TheOneTheProdigy/OMRA-LocoNet-DCC-Booster/PCB/Board Manufacturing Files/BOM_LN-DCC-Booster_V1_3.csv

ID | Name | Designator | Footprint | Quantity | Manufacturer Part | Manufacturer | Supplier | Supplier Part | Price | Pins
1 | XY2500R-C-5.08-3P | CN4,CN3,CN5 | CONN-TH_XY2500R-C-5.08-3P | 3 | XY2500R-C-5.08-3P | XINLAIYA(新莱亚) | LCSC | C505807 | 0.088 | 3
2 | 220Ω | R4,R21 | RES-TH_BD2.3-L6.5-P10.50-D0.5 | 2 | RI40-1/4W-220Ω ±5% T | CCO(千志电子) | LCSC | C136549 | 0.074 | 2
3 | 22kΩ | R5,R20,R3 | RES-TH_BD2.3-L6.5-P10.50-D0.5 | 3 | RI40-1/4W-22KΩ ±5% T | CCO(千志电子) | LCSC | C136549 | 0.074 | 2
4 | 680Ω | R6 | RES-TH_BD2.3-L6.5-P10.50-D0.5 | 1 | RI40-1/4W-680Ω ±5% T | CCO(千志电子) | LCSC | C136549 | 0.074 | 2
5 | MST 2A 250V | F1 | FUSE-TH_L8.4-W4.3-P5.08-D1.0 | 1 | MST 2A 250V | CONQUER(功得) | LCSC | C388802 | 0.042 | 2
6 | 100nF (104) | C1,C2,C4,C7 | 100NF (104) 100V 5.08MM LAYOUT 1 | 4 |  |  |  |  |  | 2
7 | 10uF (106) | C3 | 100NF (104) 100V 5.08MM LAYOUT 1 | 1 |  |  |  |  |  | 2
8 | 10uF | C6 | 100NF (104) 100V 5.08MM LAYOUT 1 | 1 |  |  |  |  |  | 2
9 | 4.7uF | C8 | 100NF (104) 100V 5.08MM LAYOUT 1 | 1 |  |  |  |  |  | 2
10 | RJ12_95501-2661 | CN1,CN2 | RJ12-TH_95501-2661 | 2 | 95501-2661 | MOLEX | LCSC | C240856 | 0.582 | 6
11 | 1N4148 | D2 | DO-35_BD2.0-L4.2-P8.20-D0.5-RD | 1 | 1N4148 | LGE(鲁光) | LCSC | C402212 | 0.008 | 2
12 | 1N4733A-TAP | D6,D8 | DO-41_BD2.4-L4.7-P8.70-D0.9-RD | 2 | 1N4733A-TAP | VISHAY(威世) | LCSC | C241985 | 0.075 | 2
13 | SSD1306-128X64-I2C-0.96 | OLED | SSD1306-128X64-I2C | 1 |  |  |  |  |  | 4
14 | 2N3904 | Q2 | TO-92-3_L5.1-W4.1-P1.27-L | 1 | 2N3904 | ST(先科) | LCSC | C118538 | 0.016 | 3
15 | 2N7000-D75Z | Q3 | TO-92-3_L4.8-W3.7-P2.54-L | 1 | 2N7000-D75Z | onsemi(安森美) | LCSC | C900718 | 0.233 | 3
16 | 47kΩ | R1 | RES-TH_BD2.3-L6.5-P10.50-D0.5 | 1 | RI40-1/4W-47KΩ ±5% T | CCO(千志电子) | LCSC | C136549 | 0.074 | 2
17 | 150kΩ | R2 | RES-TH_BD2.3-L6.5-P10.50-D0.5 | 1 | RI40-1/4W-150KΩ ±5% T | CCO(千志电子) | LCSC | C136549 | 0.074 | 2
18 | 1kΩ | R7,R10,R15 | RES-TH_BD2.3-L6.5-P10.50-D0.5 | 3 | RI40-1/4W-1KΩ ±5% T | CCO(千志电子) | LCSC | C136549 | 0.074 | 2
19 | 4k7Ω | R8,R9,R18,R19 | RES-TH_BD2.3-L6.5-P10.50-D0.5 | 4 | RI40-1/4W-4K7Ω ±5% T | CCO(千志电子) | LCSC | C136549 | 0.074 | 2
20 | 2.2kΩ | R11 | RES-TH_BD2.3-L6.5-P10.50-D0.5 | 1 | RI40-1/4W-2K2Ω ±5% T | CCO(千志电子) | LCSC | C136549 | 0.074 | 2
21 | 620Ω | R12 | RES-TH_BD2.3-L6.5-P10.50-D0.5 | 1 | RI40-1/4W-620KΩ ±5% T | CCO(千志电子) | LCSC | C136549 | 0.074 | 2
22 | 300Ω | R13,R16 | RES-TH_BD2.3-L6.5-P10.50-D0.5 | 2 | RI40-1/4W-300Ω ±5% T | CCO(千志电子) | LCSC | C136549 | 0.074 | 2
23 | 10kΩ | R14 | RES-TH_BD2.3-L6.5-P10.50-D0.5 | 1 | RI40-1/4W-10KΩ ±5% T | CCO(千志电子) | LCSC | C136549 | 0.074 | 2
24 | Arduino Pro Micro | U1 | ARDUINOPROMICRO | 1 |  |  |  |  |  | 24
25 | 6N137M | U2 | DIP-8_L9.7-W6.6-LS7.62-P2.54-BL | 1 | 6N137M | onsemi(安森美) | LCSC | C5344 | 0.637 | 8
26 | 7805 | U3 | TO-220-3_L10.0-W4.5-P2.54-L | 1 | 7805 | PUOLOP(迪浦) | LCSC | C2843718 | 0.178 | 3
27 | LM2596 | U4 | LM2596 | 1 |  |  |  |  |  | 4
28 | LM311P | U5 | DIP-8_L10.0-W6.5-P2.54-LS7.6-BL-1 | 1 | LM311P | TI(德州仪器) | LCSC | C5219 | 0.3 | 8
29 | LTV-4N35 | U6,U9 | DIP-6_L7.3-W6.5-P2.54-LS7.6-BL | 2 | LTV-4N35 | LITEON(光宝) | LCSC | C343878 | 0.153 | 6
30 | BTS7960 / IBT-2 | U7,U8 | BTS7960 | 2 |  |  |  | undefined |  | 8
31 | IBT2 | U7-2,U8-2 | IBT2 | 2
32 | B0505S-1W | U10 | PWRM-TH_BXXXXS-1W | 1 | B0505S-1W | HENIPER(恒浦) | LCSC | C234073 |  | 4
