TheOneTheProdigy/OMRA-LocoNet-DCC-Booster/PCB/Board Manufacturing Files/PCB_PCB_LN-DCC-Booster_V1_3/Multi-Layer.pdf

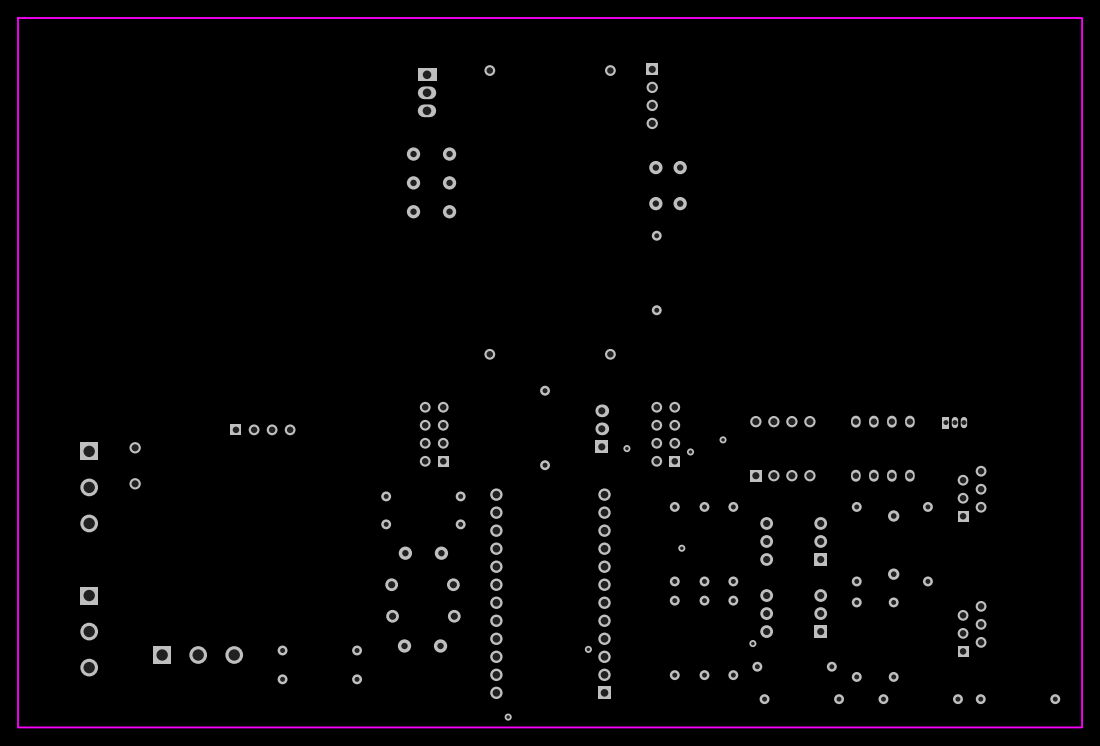
[picture p6: page 1]
