TheOneTheProdigy/OMRA-LocoNet-DCC-Booster/CHANGELOG.md

# Changelog

## v2.0

### Added or Changed

- Removed R17 From Schematics and PCB
- Replaced R5 And R20 With 22K Resistors
- Replaced R6 With 680 Ohm Resistor
- IBT2 Module Needs Slew Resistors Soldered Across To Make 0 Ohm 
- IBT2 Module Needs Current Resistors Removed To Make Open Circuit
- Updated Current Sense
- Many Bug Fixes
- Updated Dependency Libraries
- Simplified Over Current Protection
- Removed Unused Code
- Speed Up Recovery Time After Short Circuit
- Removed False Current Overload Readings

## v1.3

- Initial Upload
