TheOneTheProdigy/OMRA-LocoNet-DCC-Booster/PCB/SCHEMATIC_OMRA_LN_DCC_BOOSTER.pdf

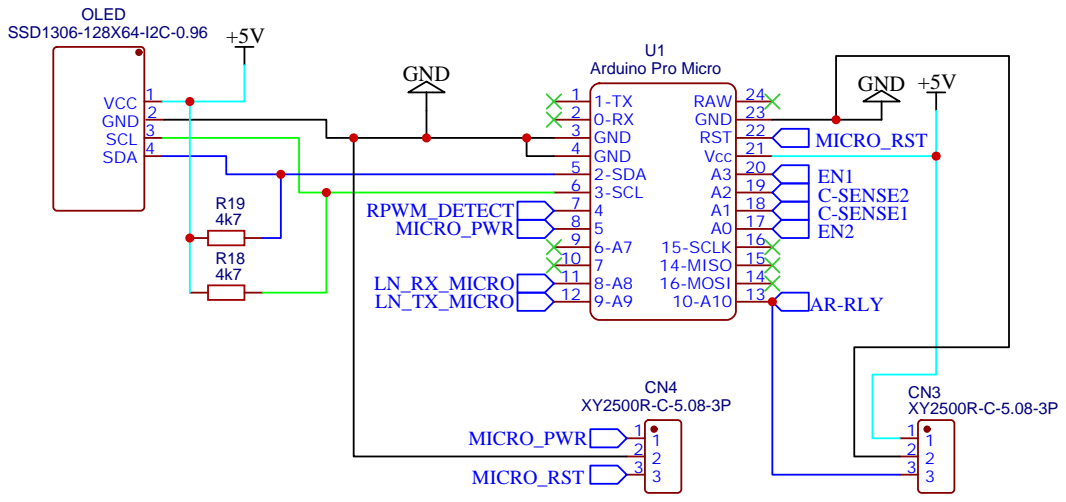
[picture p7: page 1]

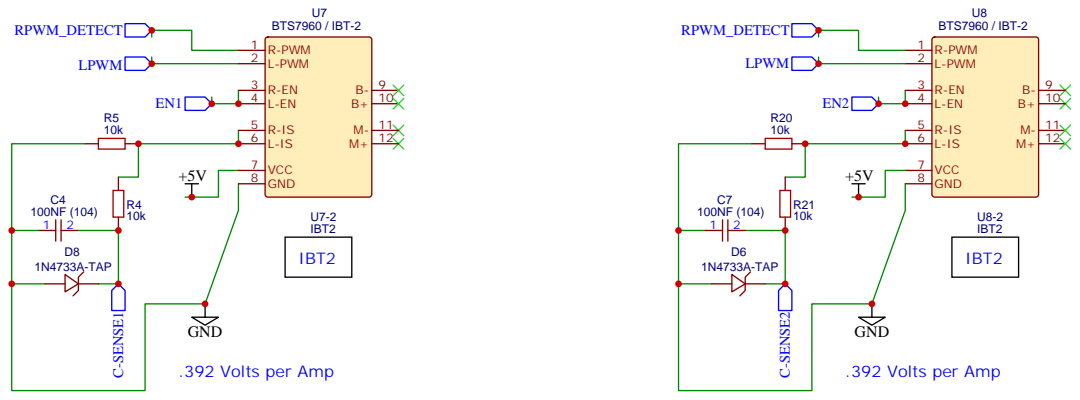
[picture p8: page 2]

Drawn By: Lance Bradley

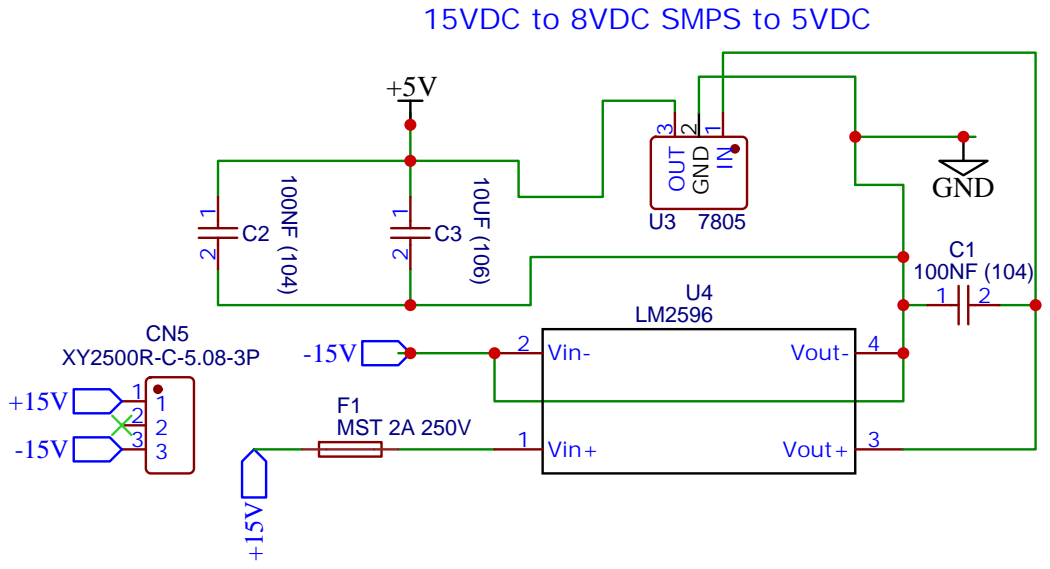
[picture p9: page 3]

## LocoNet B RailSync Booster Sync

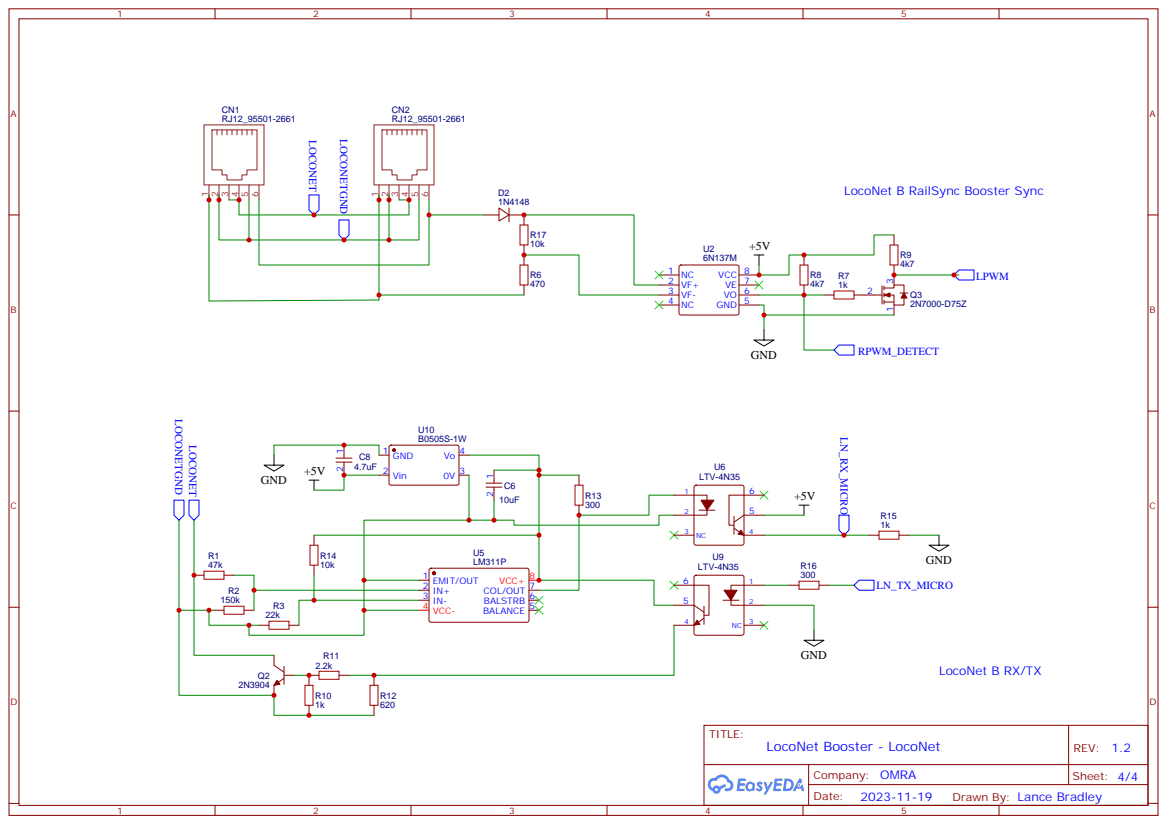
[picture p10: page 4]
