TheOneTheProdigy/OMRA-LocoNet-DCC-Booster/PCB/Schematics/Schematic_LN-DCC-Booster_V1_3.pdf

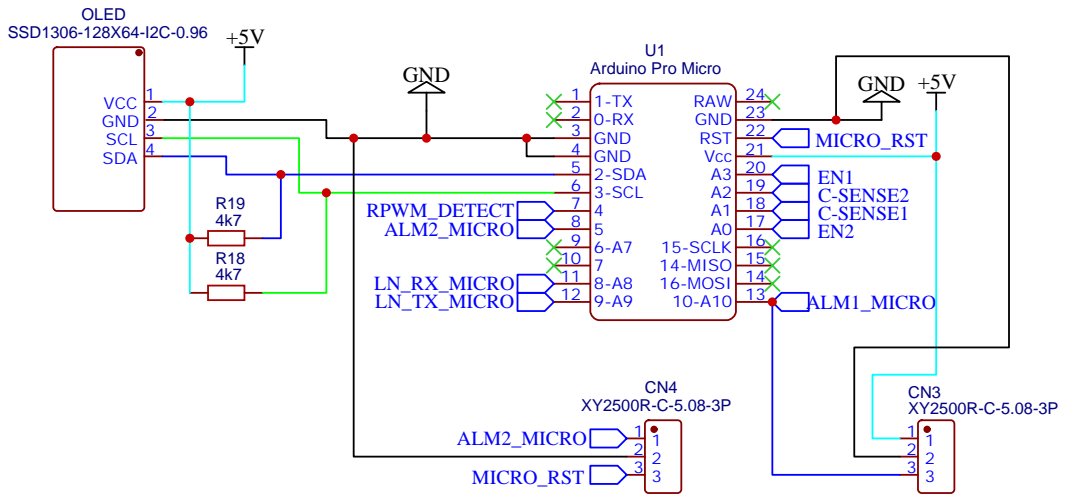
[picture p11: page 1]

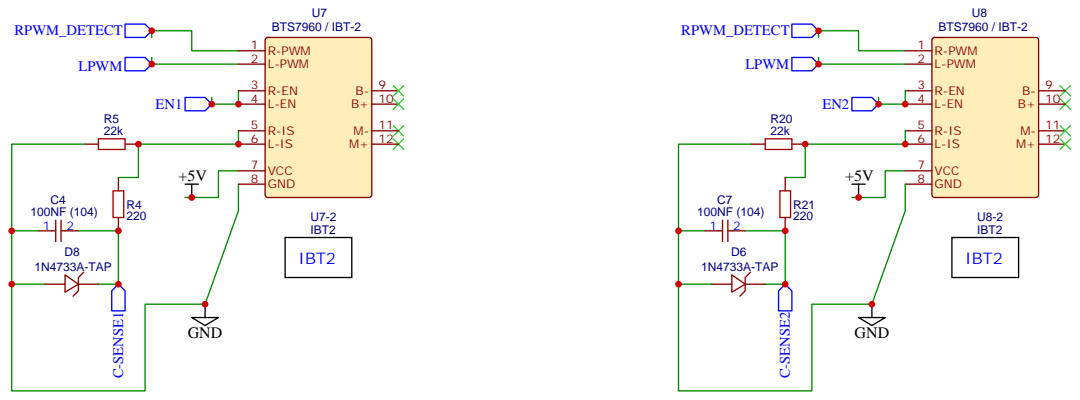
[picture p12: page 2]

Drawn By: Lance Bradley

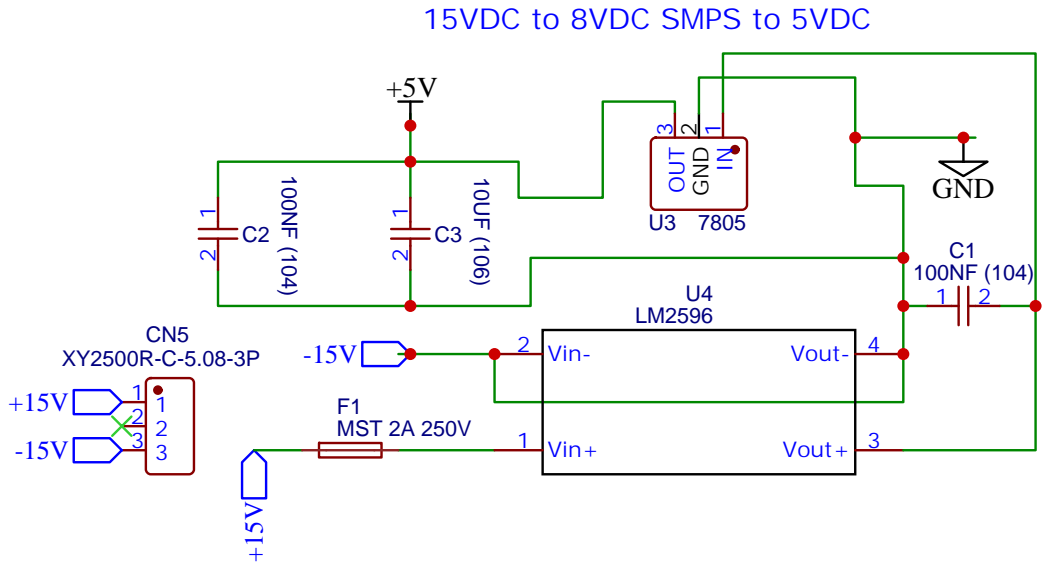
[picture p13: page 3]

## LocoNet B RailSync Booster Sync

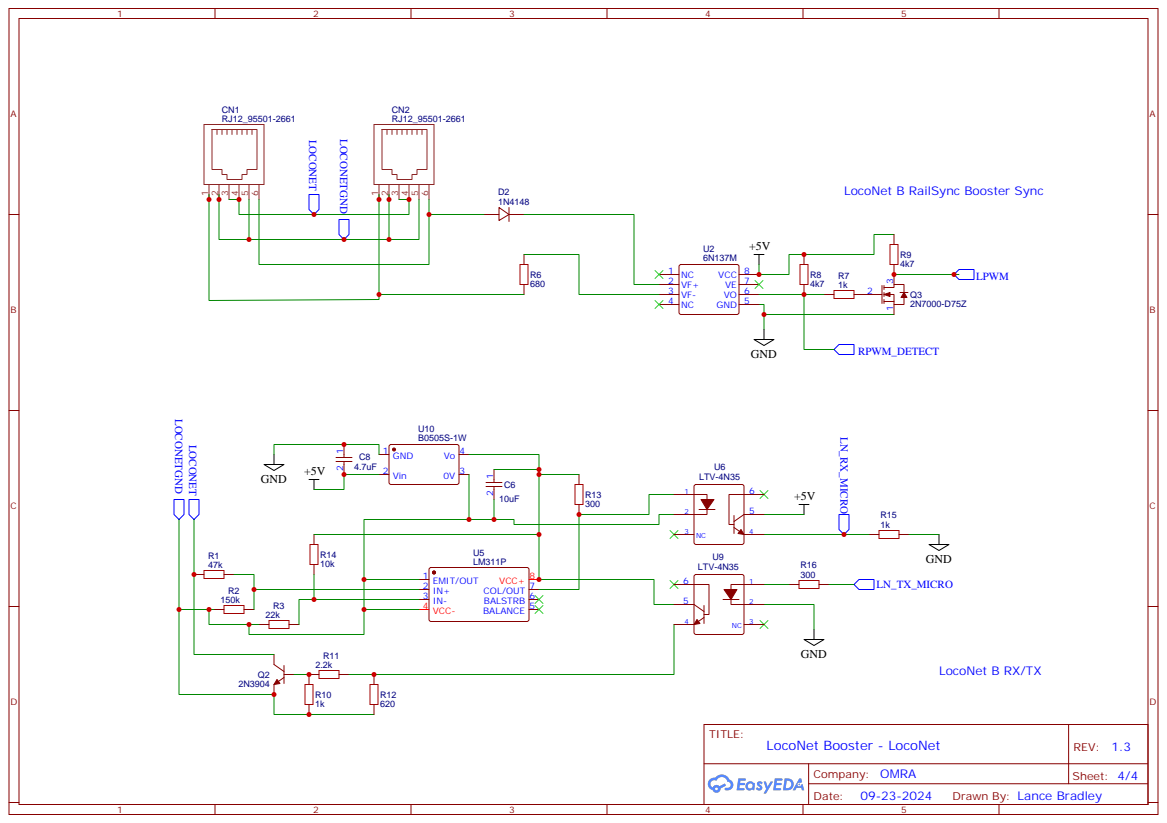
[picture p14: page 4]
