TheOneTheProdigy/OMRA-LocoNet-DCC-Booster/PCB/Board Manufacturing Files/PCB_PCB_LN-DCC-Booster_V1_3/BottomLayer.pdf

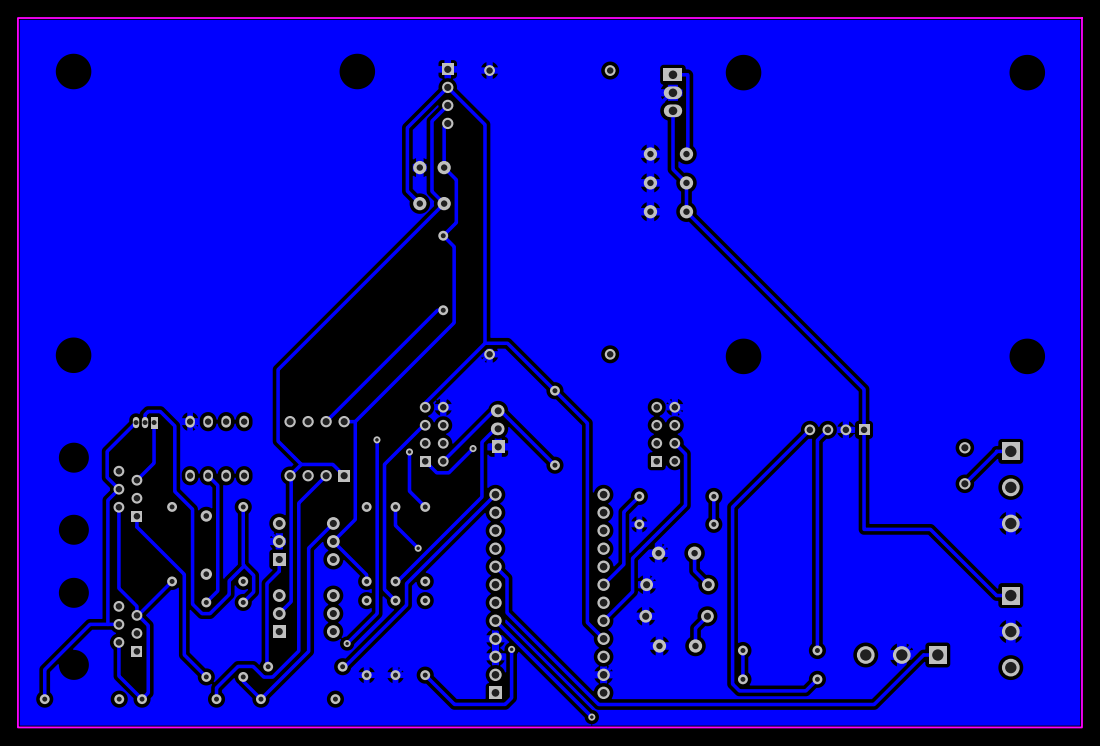
[picture p15: page 1]
