TheOneTheProdigy/OMRA-LocoNet-DCC-Booster/PCB/Board Manufacturing Files/PCB_PCB_LN-DCC-Booster_V1_3/BottomSilkLayer.pdf

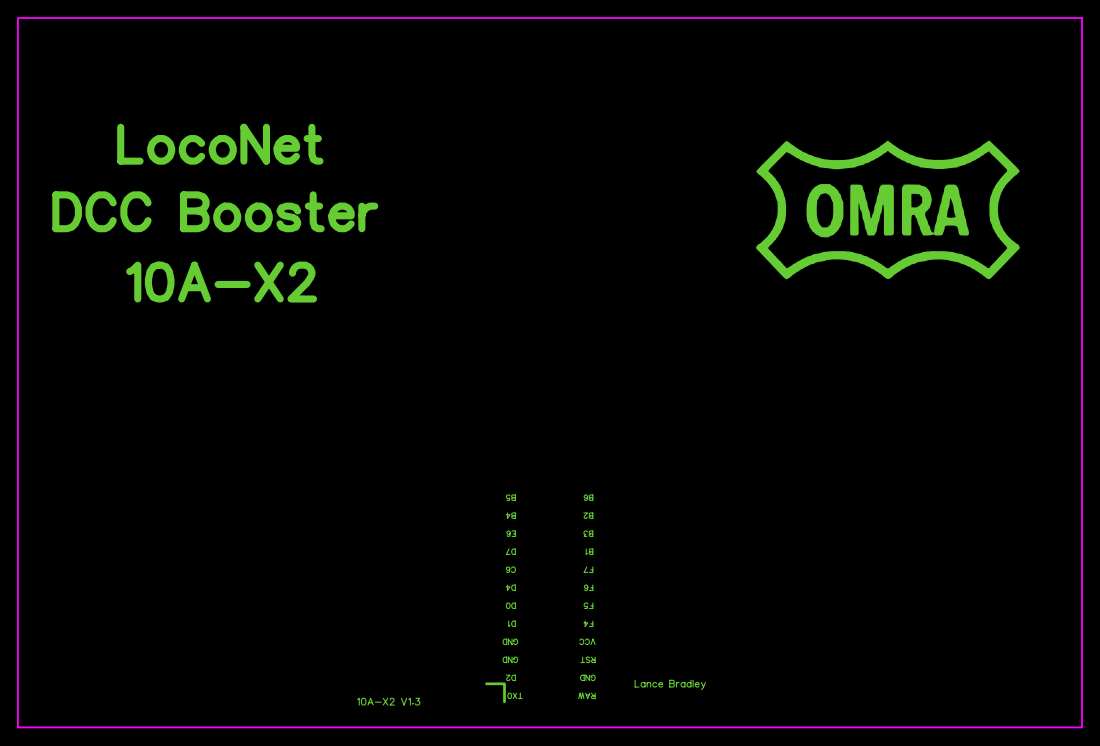
[picture p16: page 1]
