TheOneTheProdigy/OMRA-LocoNet-DCC-Booster/PCB/Board Manufacturing Files/PCB_PCB_LN-DCC-Booster_V1_3/BottomSolderMaskLayer.pdf

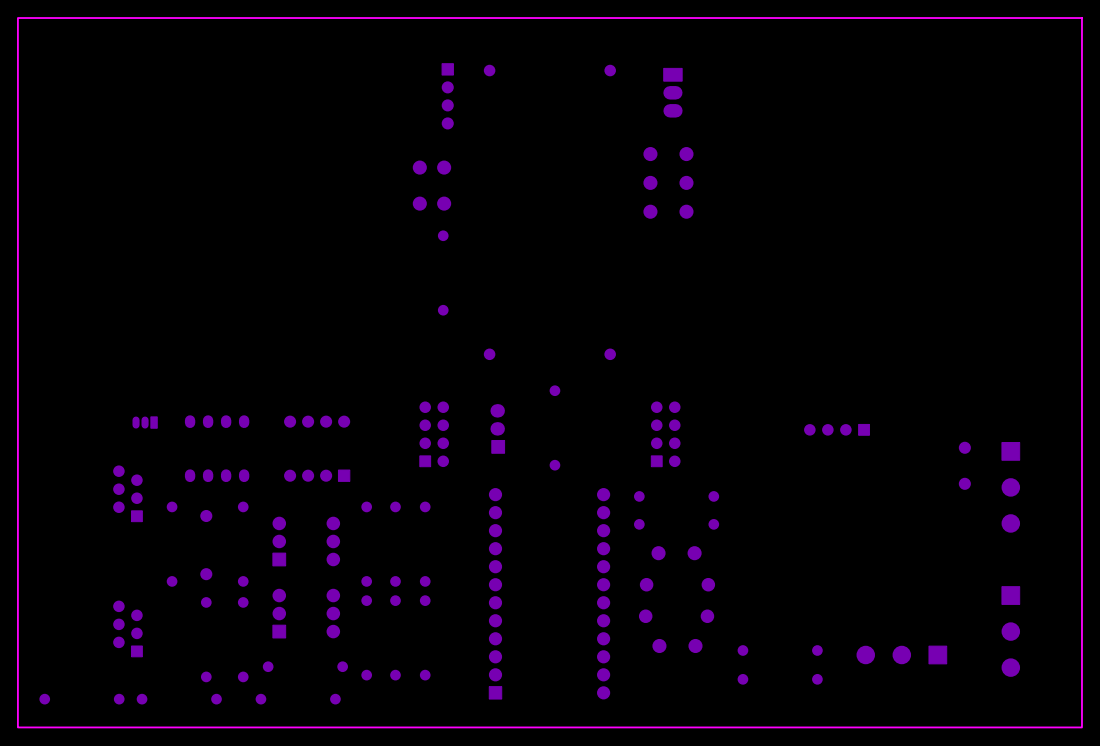
[picture p17: page 1]
