TheOneTheProdigy/OMRA-LocoNet-DCC-Booster/PCB/Board Manufacturing Files/PCB_PCB_LN-DCC-Booster_V1_3/Document.pdf

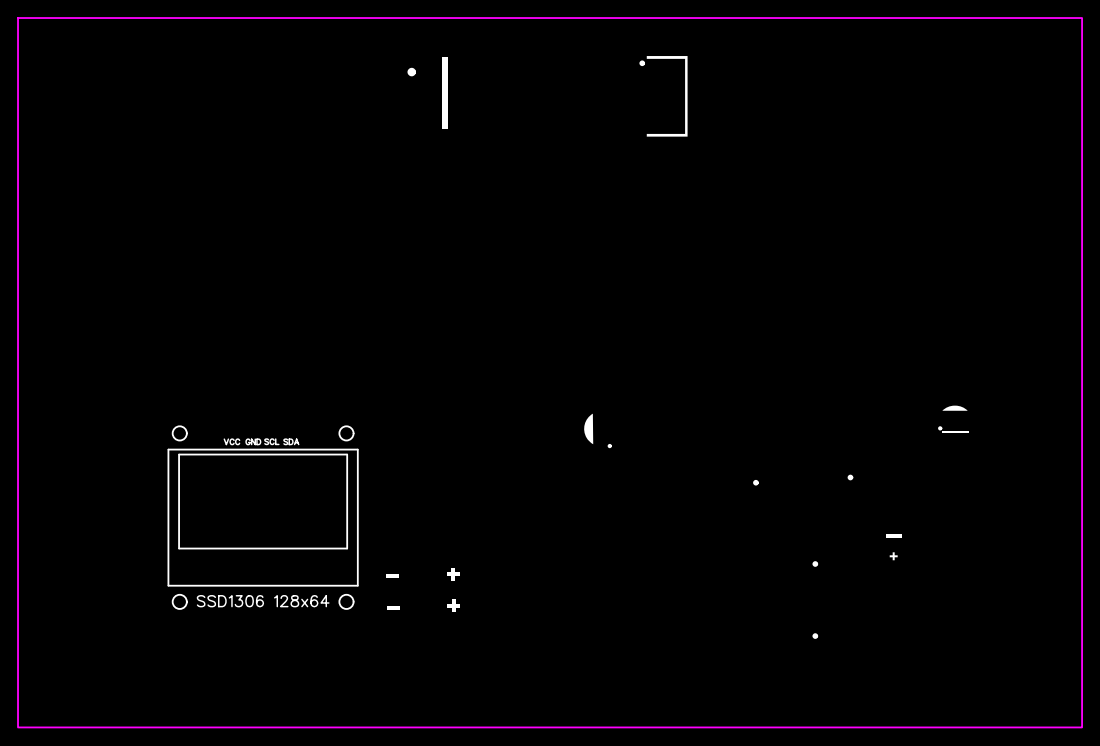
[picture p18: page 1]
