TheOneTheProdigy/OMRA-LocoNet-DCC-Booster/(list of files, drawings)

Other design files:
PCB/Board Manufacturing Files/EasyEDA Files/PCB_PCB_LN-DCC-Booster_V1_3.json
PCB/Board Manufacturing Files/EasyEDA Files/SCH_LN-DCC-Booster_V1_3.json
