TheOneTheProdigy/OMRA-LocoNet-DCC-Booster/(commit log)

2024-01-10 Create README.md / PCB Folder
2024-01-11 Update OMRA_LN_DCC_BOOSTER.ino
    Fixed Current Sense Ratio and Added SoftStart
    [OMRA_LN_DCC_BOOSTER.ino]
2024-01-16 Turned On RailSync Check And Included Folder To Make IDE Happy
2024-01-22 Current Measurements
2024-01-23 Fix Current Sense
2024-01-23 Fixed Slow and Fast Fuse Emulator
    Increased Analog Read And Cycle Time By A Factor Of 10
    [OMRA_LN_DCC_BOOSTER.ino]
2024-04-22 Version 1.3
    Updated Library BusIO to Version 1.16.0
    Updated Current Measurement Math
    Removed Lots Of Unused Code
    Removed Unused Functions and Snippets
    Changed RailSync Timeout To 250 Milli Seconds
    Moved Artwork To Separate Page To Clean Up Codebase
    Set Current Limits To Known Values To Work With Large Layouts
    Improved Short Circuit Detection Response And False Overloads
    Fixed A Bug Where Current Overload Could Occur Before The Pre Tripped Timer Finished
    Changed Slew Rate Of Boosters New Rise Time 3.6us and Fall Time 6.4us
    ** Hardware Changes Needed For This Version **
    Slew Resistors For IBT-2 Modules Removed And Pads Shorted (Bridged)
    R5 and R20 (10K) Both Removed
    [ARTWORK.h, OMRA_LN_DCC_BOOSTER.ino]
2024-04-26 Update OMRA_LN_DCC_BOOSTER.ino for alarm function
    Added alarm functions for output on Arduino pins 6 and 7 to LED and piezo display. Each output pin reflects short status from one IBT-2.
    [OMRA_LN_DCC_BOOSTER.ino]
2024-04-26 Update OMRA_LN_DCC_BOOSTER.ino
    Added Serial output of calibration values at startup for easier documentation.
2024-04-26 Add files via upload
    Added code in the Startup function to print the four calibration values to the Serial port. This preserves the existing functionality to print suggested calibration values if desired, but will print the current calibration values ONCE at startup.
2024-06-19 Update OMRA_LN_DCC_BOOSTER.ino with output and short circuit alarm functions.
    Corrected error in the serial output of calibration functions on startup.
    Added external alarm capability for short circuit alarms for each booster output - two alarm outputs per booster. Each alarm circuit has a separate ground back to the respective booster board.
    [OMRA_LN_DCC_BOOSTER.ino]
2024-09-24 Version 2.0
    Updated Current Sense
    Many Bug Fixes
    Updated Dependency Libraries
    Simplified Over Current Protection
    Removed Unused Code
    Speed Up Recovery Time After Short Circuit
    Removed False Current Overload Readings
    [BOM_LN-DCC-Booster_V1_3.csv, BOM_OMRA_LN_DCC_BOOSTER.xlsx, PCB_PCB_LN-DCC-Booster_V1_3.json, SCH_LN-DCC-Booster_V1_3.json]
2025-01-24 Update OMRA_LN_DCC_BOOSTER.ino
    Reverted Current Measurements To Formula
    Removed Unused Variables
    Made Setup More User Friendly
    [OMRA_LN_DCC_BOOSTER.ino]
2025-01-25 Update OMRA_LN_DCC_BOOSTER.ino
    Fixed compile errors pointed out from Kurt, Bumped version.
    [OMRA_LN_DCC_BOOSTER.ino]
2026-01-04 V2.1.10
    Firmware Changes To Enable New DRV8874 OMRA Modules And Greatly Improved Current Sensing.
2026-01-05 Update OMRA_LN_DCC_BOOSTER.ino
    Fixed Booster 2 Hardware Error Not Resetting Properly
    [OMRA_LN_DCC_BOOSTER.ino]
2026-09-06 Fine Tune Default Current Settings
